utkuoguzman/portal_gun_source_code/fritzing_breadboard_diagram.png

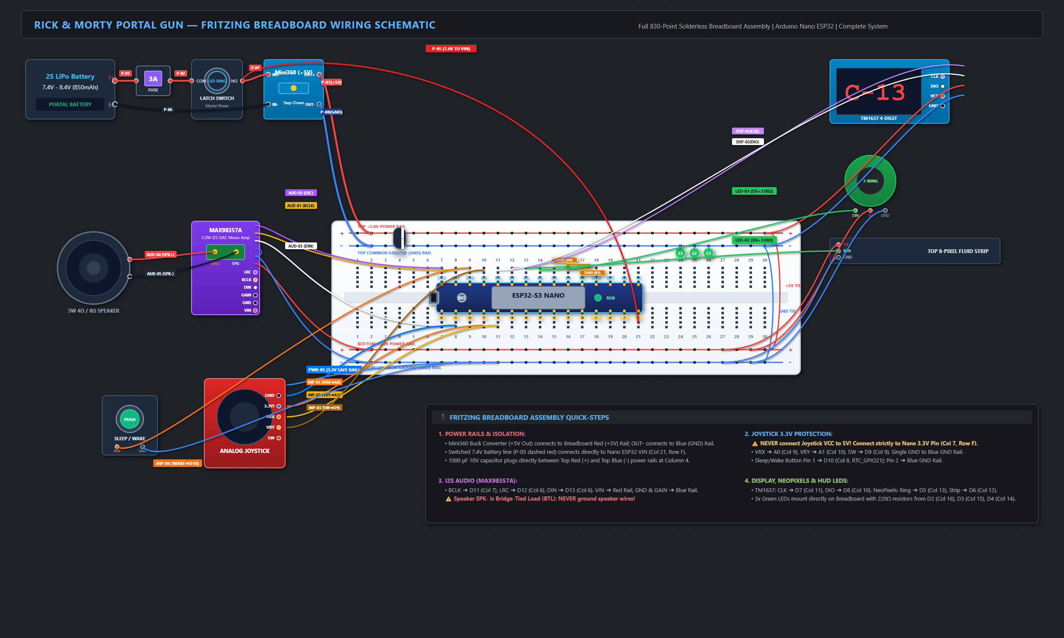
fritzing_breadboard_diagram.png
