utkuoguzman/portal_gun_source_code/site_assets/portal_background.jpg

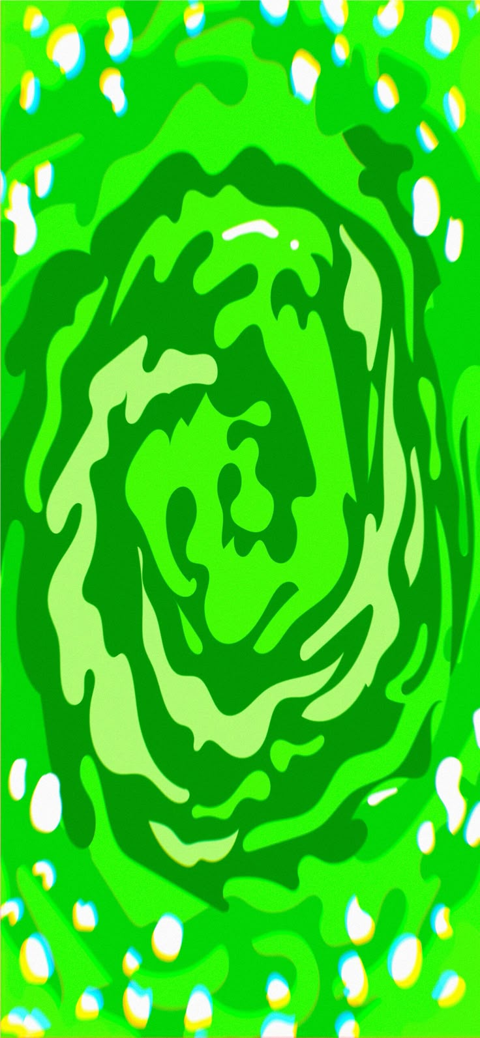
site_assets/portal_background.jpg
