utkuoguzman/portal_gun_source_code/site_assets/rick-dance.gif

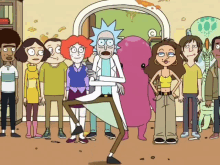
site_assets/rick-dance.gif
