utkuoguzman/portal_gun_source_code/(list of files, cad)

Other CAD files:
3D_model/Portal_Gun_v2.1.blend
