utkuoguzman/portal_gun_source_code/wiring_diagram.png

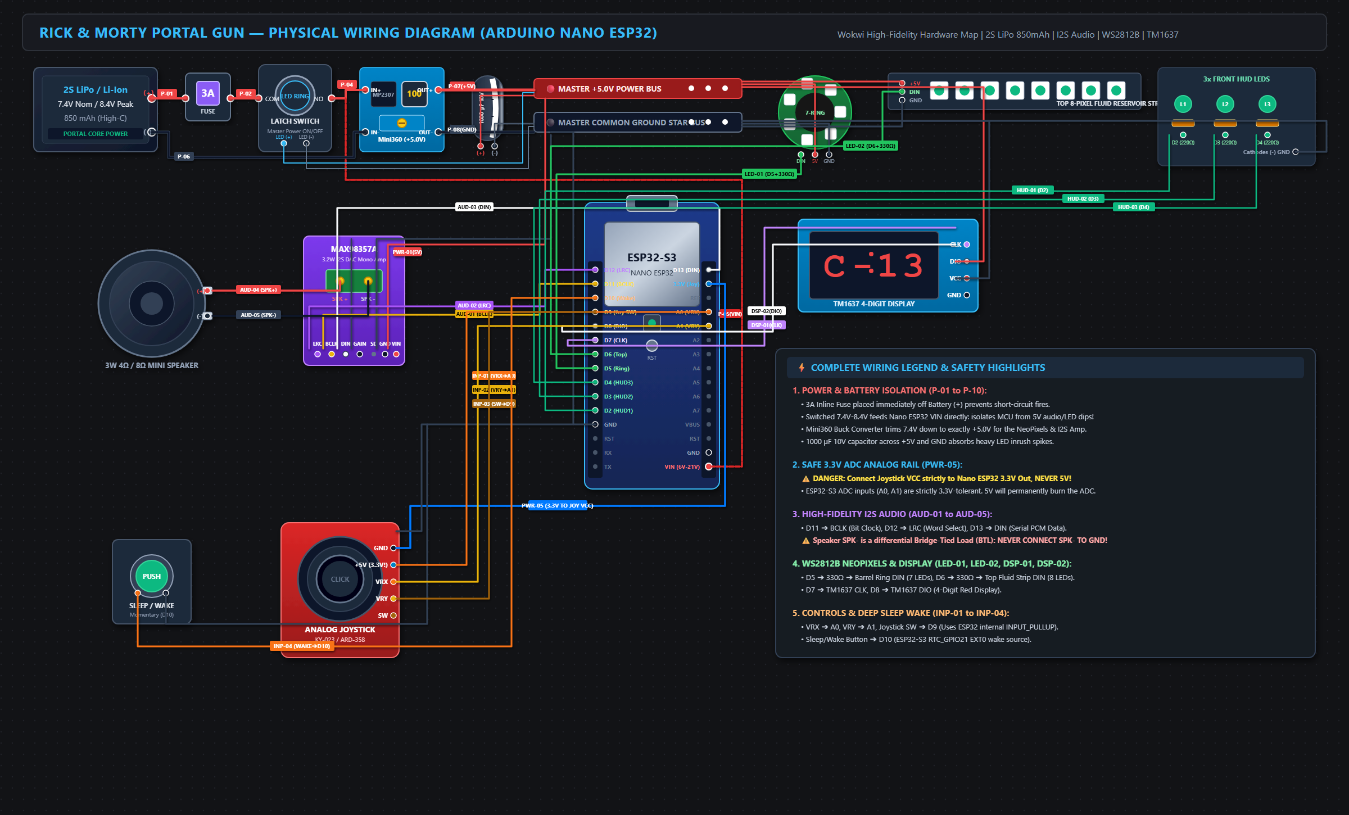
wiring_diagram.png
