utkuoguzman/portal_gun_source_code/tests/README.md

# Tests

This directory is reserved for unit tests or integration tests.
For now, the primary test path is running the Wokwi simulation and verifying the behavior of the main state machine.
