utkuoguzman/portal_gun_source_code/(list of files, drawings)

Other design files:
portal_gun.fz
portal_gun.fzz
portal_gun_easyeda.json
