utkuoguzman/portal_gun_source_code/src/main.cpp

#include <Arduino.h>
#include "input.h"
#include "leds.h"
#include "display.h"
#include "audio.h"
#include "portal_gun.h"
#include "radar.h"
#include "wifi_portal.h"
#ifdef NAKED_TEST_MODE
#include "naked_test.h"
#endif

void setup() {
#ifdef NAKED_TEST_MODE
    setupNakedTest();
#else
    Serial.begin(115200);
    delay(100);
    Serial.println("Portal Gun Boot");
    Serial.println("ESP32 initialized");
    
    input.begin();
    Serial.println("Joystick initialized");
    
    display.begin();
    Serial.println("Display initialized");
    
    leds.begin();
    Serial.println("LED system initialized");
    
    audio.begin();
    Serial.println("Audio initialized");

    radar.begin();
    Serial.println("Radar system initialized");

    wifiPortal.begin();
    Serial.println("Wi-Fi Captive Portal initialized");
    
    portalGun.begin();
#endif
}

void loop() {
#ifdef NAKED_TEST_MODE
    loopNakedTest();
#else
    input.update();
    portalGun.update();
    leds.update();
    display.update();
    audio.update();
    radar.update();
    wifiPortal.update();
#endif
}
