utkuoguzman/portal_gun_source_code/include/app_state.h

#pragma once

enum class PortalState {
    PowerUp,
    PowerUpFinalize,
    DimensionSelection,
    Party,
    Torch,
    RadarScan,
    WifiPortal,
    EvilMorty,
    SnakeGame,
    Roulette,
    DinoGame,
    RickQuote,
    PowerDown,
    DeepSleep
};
