utkuoguzman/portal_gun_source_code/src/modules/site_assets.cpp

#include "site_assets.h"

const size_t portal_background_jpg_size = 17780;
const uint8_t portal_background_jpg[] PROGMEM = {
    0xff, 0xd8, 0xff, 0xe0, 0x00, 0x10, 0x4a, 0x46, 0x49, 0x46, 0x00, 0x01, 0x01, 0x00, 0x00, 0x01,
    0x00, 0x01, 0x00, 0x00, 0xff, 0xdb, 0x00, 0x43, 0x00, 0x0c, 0x08, 0x09, 0x0b, 0x09, 0x08, 0x0c,
    0x0b, 0x0a, 0x0b, 0x0e, 0x0d, 0x0c, 0x0e, 0x12, 0x1e, 0x14, 0x12, 0x11, 0x11, 0x12, 0x25, 0x1b,
    0x1c, 0x16, 0x1e, 0x2c, 0x27, 0x2e, 0x2e, 0x2b, 0x27, 0x2b, 0x2a, 0x31, 0x37, 0x46, 0x3b, 0x31,
    0x34, 0x42, 0x34, 0x2a, 0x2b, 0x3d, 0x53, 0x3e, 0x42, 0x48, 0x4a, 0x4e, 0x4f, 0x4e, 0x2f, 0x3b,
    0x56, 0x5c, 0x55, 0x4c, 0x5b, 0x46, 0x4d, 0x4e, 0x4b, 0xff, 0xdb, 0x00, 0x43, 0x01, 0x0d, 0x0e,
    0x0e, 0x12, 0x10, 0x12, 0x24, 0x14, 0x14, 0x24, 0x4b, 0x32, 0x2b, 0x32, 0x4b, 0x4b, 0x4b, 0x4b,
    0x4b, 0x4b, 0x4b, 0x4b, 0x4b, 0x4b, 0x4b, 0x4b, 0x4b, 0x4b, 0x4b, 0x4b, 0x4b, 0x4b, 0x4b, 0x4b,
    0x4b, 0x4b, 0x4b, 0x4b, 0x4b, 0x4b, 0x4b, 0x4b, 0x4b, 0x4b, 0x4b, 0x4b, 0x4b, 0x4b, 0x4b, 0x4b,
    0x4b, 0x4b, 0x4b, 0x4b, 0x4b, 0x4b, 0x4b, 0x4b, 0x4b, 0x4b, 0x4b, 0x4b, 0x4b, 0x4b, 0xff, 0xc0,
    0x00, 0x11, 0x08, 0x01, 0xe0, 0x00, 0xde, 0x03, 0x01, 0x22, 0x00, 0x02, 0x11, 0x01, 0x03, 0x11,
    0x01, 0xff, 0xc4, 0x00, 0x1b, 0x00, 0x00, 0x03, 0x00, 0x03, 0x01, 0x01, 0x00, 0x00, 0x00, 0x00,
    0x00, 0x00, 0x00, 0x00, 0x00, 0x00, 0x04, 0x05, 0x06, 0x00, 0x02, 0x03, 0x01, 0x07, 0xff, 0xc4,
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
    0x00, 0x0c, 0x40, 0xc2, 0x00, 0x2e, 0xd6, 0x04, 0xc0, 0x7e, 0x44, 0x4a, 0xd0, 0xdf, 0x7f, 0x04,
    0x0a, 0x78, 0xd5, 0x56, 0x0a, 0xa0, 0xb0, 0x9d, 0x09, 0x92, 0x15, 0x80, 0x82, 0x73, 0x62, 0x4d,
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
};
