utkuoguzman/portal_gun_source_code/include/soundboard_data.h

#pragma once
#include <stdint.h>
#include <stddef.h>
#include "audio_assets.h"

extern const uint8_t snd_rick_pickle[];
extern const size_t snd_rick_pickle_size;
extern const uint8_t snd_rick_bored[];
extern const size_t snd_rick_bored_size;
extern const uint8_t snd_rick_bitch[];
extern const size_t snd_rick_bitch_size;
extern const uint8_t snd_rick_butter[];
extern const size_t snd_rick_butter_size;
extern const uint8_t snd_rick_cpu[];
extern const size_t snd_rick_cpu_size;
extern const uint8_t snd_rick_cromulon[];
extern const size_t snd_rick_cromulon_size;
extern const uint8_t snd_rick_cute[];
extern const size_t snd_rick_cute_size;
extern const uint8_t snd_rick_dance[];
extern const size_t snd_rick_dance_size;
extern const uint8_t snd_rick_devil[];
extern const size_t snd_rick_devil_size;
extern const uint8_t snd_rick_drink[];
extern const size_t snd_rick_drink_size;
extern const uint8_t snd_rick_errand[];
extern const size_t snd_rick_errand_size;
extern const uint8_t snd_rick_gaf[];
extern const size_t snd_rick_gaf_size;
extern const uint8_t snd_rick_girls[];
extern const size_t snd_rick_girls_size;
extern const uint8_t snd_rick_goback[];
extern const size_t snd_rick_goback_size;
extern const uint8_t snd_rick_hands[];
extern const size_t snd_rick_hands_size;
extern const uint8_t snd_rick_icecream[];
extern const size_t snd_rick_icecream_size;
extern const uint8_t snd_rick_imhaving[];
extern const size_t snd_rick_imhaving_size;
extern const uint8_t snd_rick_know[];
extern const size_t snd_rick_know_size;
extern const uint8_t snd_rick_makeout[];
extern const size_t snd_rick_makeout_size;
extern const uint8_t snd_rick_meet[];
extern const size_t snd_rick_meet_size;
extern const uint8_t snd_rick_months[];
extern const size_t snd_rick_months_size;
extern const uint8_t snd_rick_more[];
extern const size_t snd_rick_more_size;
extern const uint8_t snd_rick_osmf[];
extern const size_t snd_rick_osmf_size;
extern const uint8_t snd_rick_os[];
extern const size_t snd_rick_os_size;
extern const uint8_t snd_rick_oldsong[];
extern const size_t snd_rick_oldsong_size;
extern const uint8_t snd_rick_operation[];
extern const size_t snd_rick_operation_size;
extern const uint8_t snd_rick_page[];
extern const size_t snd_rick_page_size;
extern const uint8_t snd_rick_party[];
extern const size_t snd_rick_party_size;
extern const uint8_t snd_rick_people[];
extern const size_t snd_rick_people_size;
extern const uint8_t snd_rick_player[];
extern const size_t snd_rick_player_size;
extern const uint8_t snd_rick_rickless[];
extern const size_t snd_rick_rickless_size;
extern const uint8_t snd_rick_rubber[];
extern const size_t snd_rick_rubber_size;
extern const uint8_t snd_rick_satisfaction[];
extern const size_t snd_rick_satisfaction_size;
extern const uint8_t snd_rick_shady[];
extern const size_t snd_rick_shady_size;
extern const uint8_t snd_rick_sleep[];
extern const size_t snd_rick_sleep_size;
extern const uint8_t snd_rick_sucks[];
extern const size_t snd_rick_sucks_size;
extern const uint8_t snd_rick_sweetie[];
extern const size_t snd_rick_sweetie_size;
extern const uint8_t snd_rick_thankyou[];
extern const size_t snd_rick_thankyou_size;
extern const uint8_t snd_rick_whiskey[];
extern const size_t snd_rick_whiskey_size;
extern const uint8_t snd_rick_yorn[];
extern const size_t snd_rick_yorn_size;
extern const uint8_t snd_rick_riggity[];
extern const size_t snd_rick_riggity_size;
extern const uint8_t snd_rick_rickytiffy[];
extern const size_t snd_rick_rickytiffy_size;
extern const uint8_t snd_rick_wubba[];
extern const size_t snd_rick_wubba_size;
extern const uint8_t snd_rick_rickmorty[];
extern const size_t snd_rick_rickmorty_size;

extern const Soundbyte rick_soundboard[];
extern const size_t rick_soundboard_count;
