utkuoguzman/portal_gun_source_code/include/site_assets.h

#pragma once
#include <Arduino.h>

extern const uint8_t portal_background_jpg[] PROGMEM;
extern const size_t portal_background_jpg_size;

extern const uint8_t rick_dance_gif[] PROGMEM;
extern const size_t rick_dance_gif_size;
