utkuoguzman/portal_gun_source_code/include/extra_audio.h

#pragma once
#include <stdint.h>
#include <stddef.h>

extern const uint8_t snd_evil_morty[];
extern const size_t snd_evil_morty_size;

extern const uint8_t snd_roulette_spin[];
extern const size_t snd_roulette_spin_size;

extern const uint8_t snd_roulette_clack[];
extern const size_t snd_roulette_clack_size;

extern const uint8_t snd_roulette_boom[];
extern const size_t snd_roulette_boom_size;

extern const uint8_t snd_roulette_wrecked[];
extern const size_t snd_roulette_wrecked_size;

extern const uint8_t snd_snake_jazz[];
extern const size_t snd_snake_jazz_size;

extern const uint8_t snd_dino_song[];
extern const size_t snd_dino_song_size;
