utkuoguzman/portal_gun_source_code/(commit log)

2026-10-16 added dino, wvil morty, snake, roullette, rick quotes, radar, wifi page (buttons, selecting featured dimensions, beam color tuning)
2026-10-19 fix wire diagram
2026-10-24 pin change
2026-10-25 fix schematics
2026-10-30 fix wifi and bluetooth and switch
