utkuoguzman/portal_gun_source_code/(notices)

Notices in the files:
README.md:
License: GPL v3
